nguyen1013/adc-project/img/breadboard-adc-processing.jpg

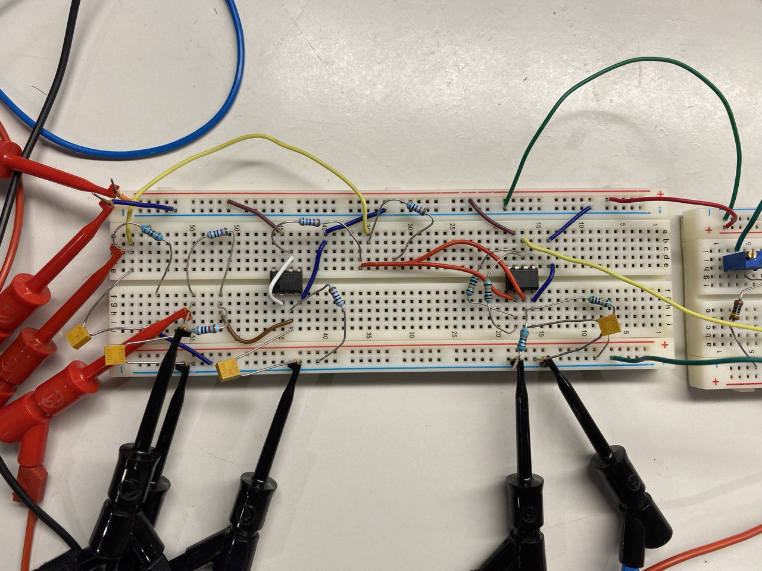
img/breadboard-adc-processing.jpg
