nguyen1013/adc-project/img/breadboard-adc.jpg

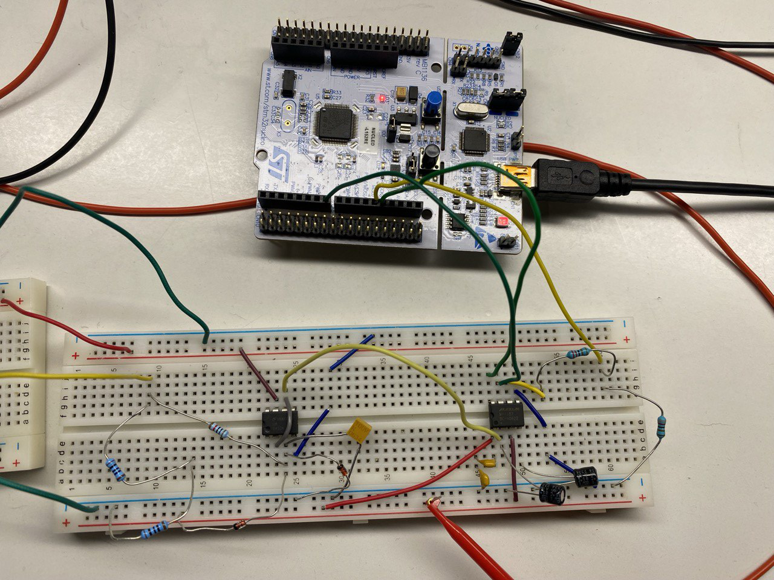
img/breadboard-adc.jpg
