nguyen1013/adc-project/img/breadboard-receiver.jpg

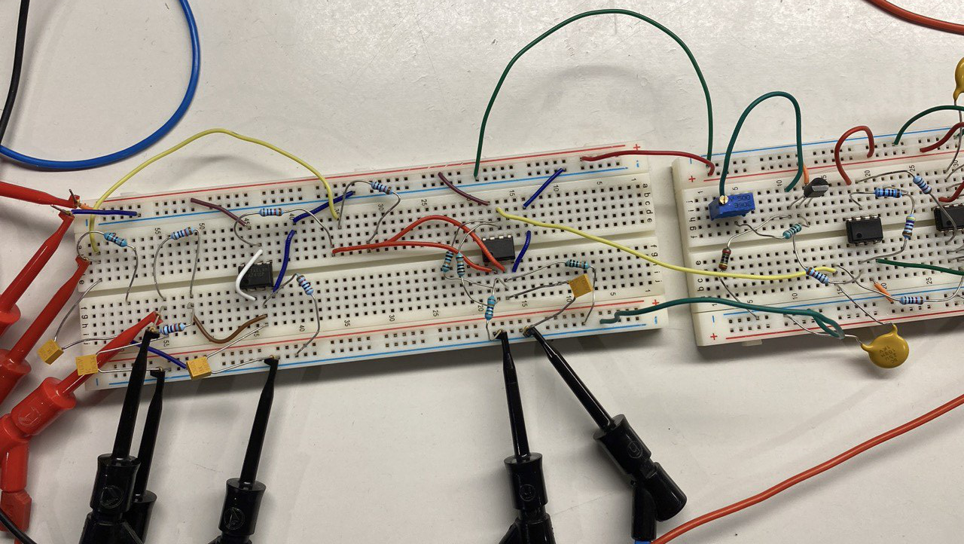
img/breadboard-receiver.jpg
