nguyen1013/adc-project/img/breadboard-transmitter.jpg

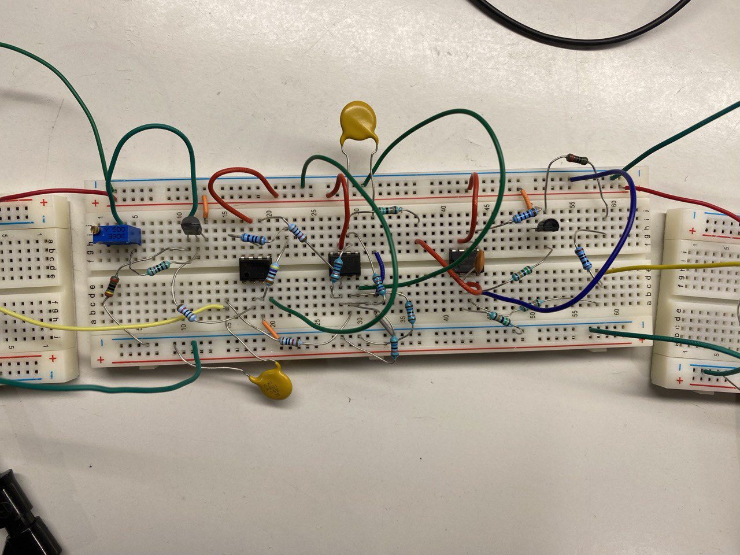
img/breadboard-transmitter.jpg
