nguyen1013/adc-project/LTspice-simulation/TI-4-20mA/11-TI-circuit-4-20mA.png

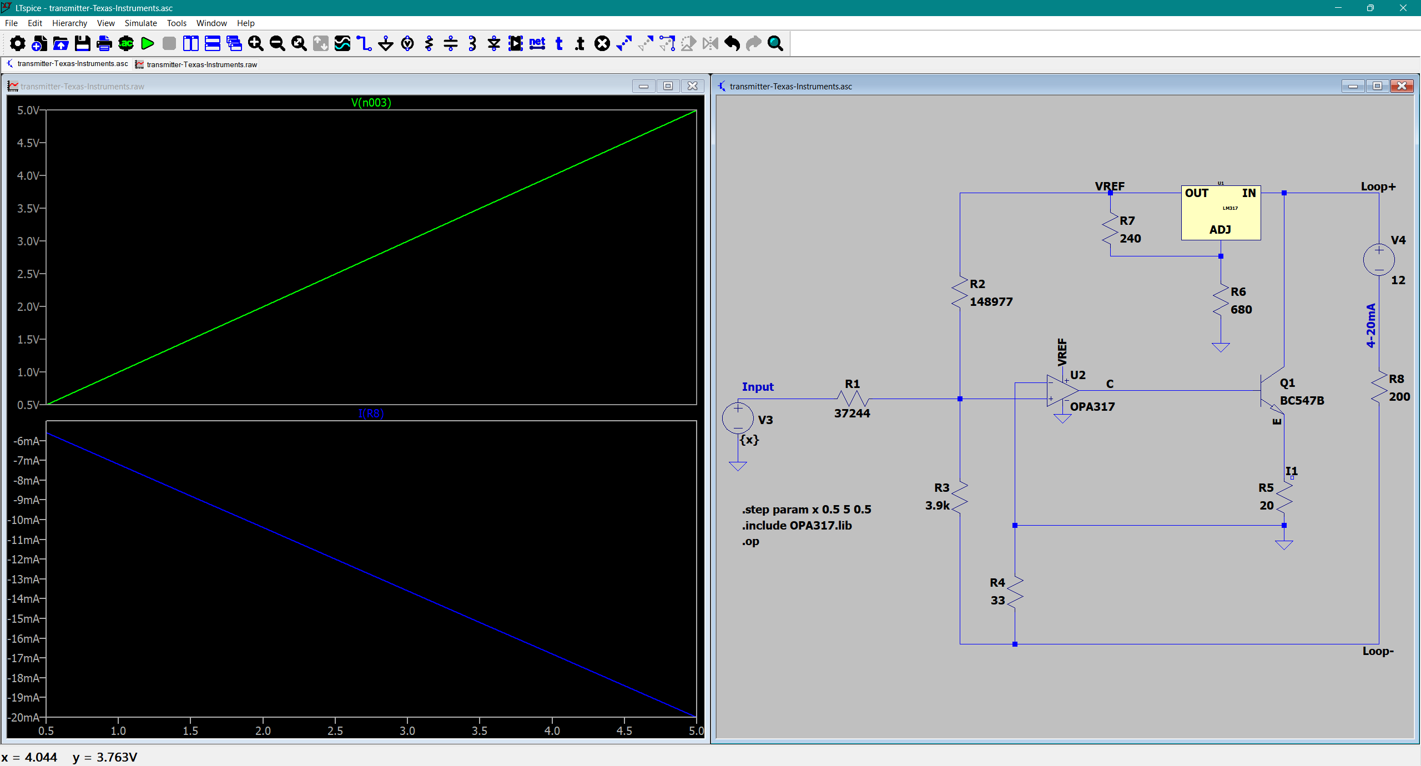
LTspice-simulation/TI-4-20mA/11-TI-circuit-4-20mA.png
