nguyen1013/adc-project/LTspice-simulation/LM35.asc

C1: cap; 1µ
V1: voltage; {x}
V2: voltage; 1.2
Named nets: Vin, Vout1, Vout2, 0
.tran 100
.STEP param x 0.65 2.7 0.1
