nguyen1013/adc-project/LTspice-simulation/LM35_analog_processing.asc

C1: cap; 10n
C2: cap; 10n
C3: cap; 100n
C4: cap; 10n
C5: cap; 10n
C6: cap; 10n
D1: diode; 1N914
D2: diode; 1N914
LM35: LM35
R1: res; 5k
R2: res; 10k
R3: res; 50k
R4: res; 10k
R5: res; 50k
R6: res; 10k
R7: res; 18k
U1: opamp2; LM741/NS
U2: opamp2; LM741/NS
Named nets: C, A, Uout1, VCC1, B, VEE1, GND1
