nguyen1013/adc-project/LTspice-simulation/receiver.asc

C1: cap; 10n
D1: diode; 1N4148
D2: diode; 1N4148
LM741: UniversalOpAmp
R2: res; 200
R3: res; 10k
V1: voltage; 5
Named nets: VCC3, VEE3, Iin, Uout2, GND3, 0
4-20mA
input current 4-20mA generate output voltage 0.8-4V
