nguyen1013/adc-project/LTspice-simulation/simulation.asc

LM35_analog_processing: LM35_analog_processing
Receiver: receiver
Transmitter_4-20mA: transmitter_4-20mA
V1: voltage; 12
V2: voltage; 12
Named nets: 0, VEE, VCC, Uout_ADC
.step param x 0.8 1.8 0.2
.inc nat_semi.lib
.op
To ADC converter (MAX187)
Temperature range -40 to 60 degree C
Analog processing 0-5V
Transmitter current 4-20mA
Receiver Output votalge to ADC converter 0.8-4V
