nguyen1013/adc-project/LTspice-simulation/transmitter_4-20mA.asc

C1: cap; 100n
C2: cap; 10n
C3: cap; 10n
C4: cap; 10n
C5: cap; 10n
Q1: npn; BC547B
R1: res; 250
R3: res; 150k
R3a: res; 150k
R4: res; 100
R4a: res; 150k
R5: res; 150k
R7: res; 10k
R9: res; 8k
R10: res; 8k
R11: res; 240
R12: res; 240
R13: res; 10k
R14: res; 4.8k
R15: res; 10k
U1: opamp2; LM741/NS
U2: opamp2; LM741/NS
U4: LM317
U5: opamp2; LM741/NS
Named nets: C, Iout, Uin1, GND2, VEE2, VCC2
.include nat_semi.lib
4-20mA
Input
