nguyen1013/adc-project/LTspice-simulation/TI-4-20mA/transmitter-Texas-Instruments.asc

Q1: npn; BC547B
R1: res; 37244
R2: res; 148977
R3: res; 3.9k
R4: res; 33
R5: res; 20
R6: res; 680
R7: res; 240
R8: res; 200
U1: LM317
U2: opamp2; OPA317
V3: voltage; {x}
V4: voltage; 12
Named nets: I1, 0, C, E, VREF, Loop+, Loop-
.op
4-20mA
Input
.step param x 0.5 5 0.5
.include OPA317.lib
