nguyen1013/adc-project/testing-thumbnail.png

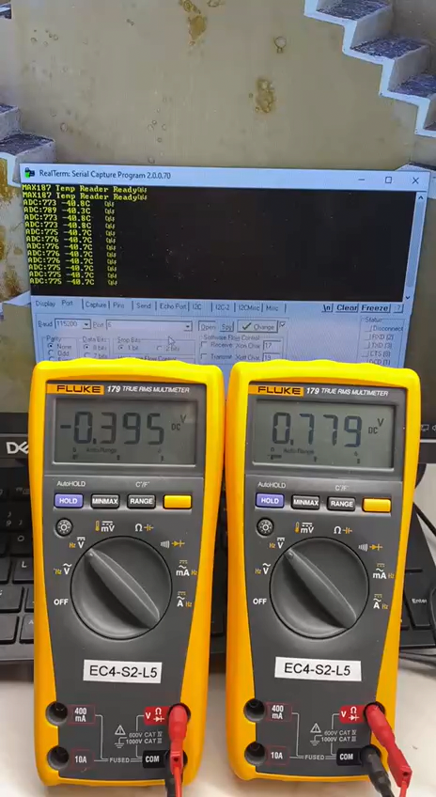
testing-thumbnail.png
