nguyen1013/adc-project/code/src/timer.h

/*
 * timer.h
 *
 *  Created on: 27 thg 11, 2025
 *      Author: nguyen
 */

#ifndef TIMER_H_
#define TIMER_H_

void Timer3_Init(void);
void delay_ms(int ms);
void delay_10us(void);

#endif /* TIMER_H_ */
