nguyen1013/adc-project/(commit log)

2026-01-06 TI current loop 4-20mA
2026-01-06 Modify project description with additional detail
    Updated project description to include LTspice simulation and STM32 L152RE details.
